esRueda/WeatherStation/CSE/Display Photos/20200113_080433.jpg

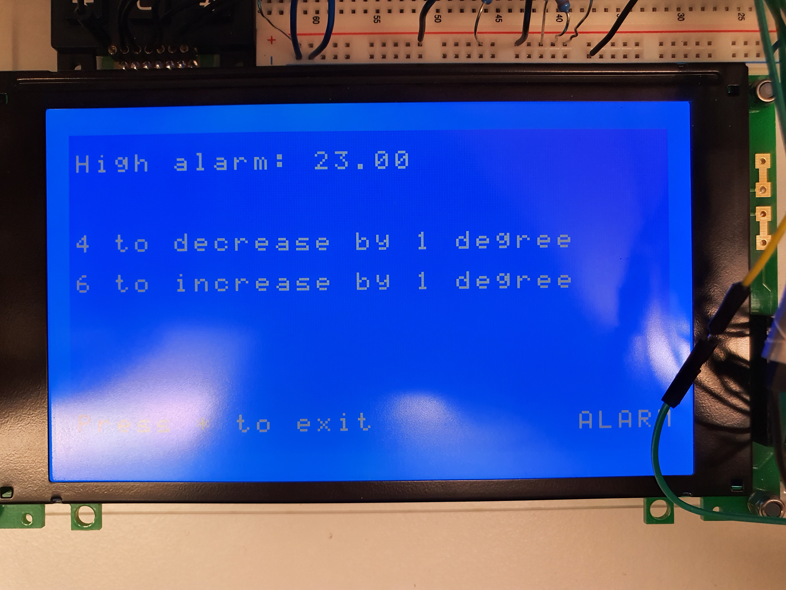
CSE/Display Photos/20200113_080433.jpg
