esRueda/WeatherStation/CSE/Display Photos/20200113_075914.jpg

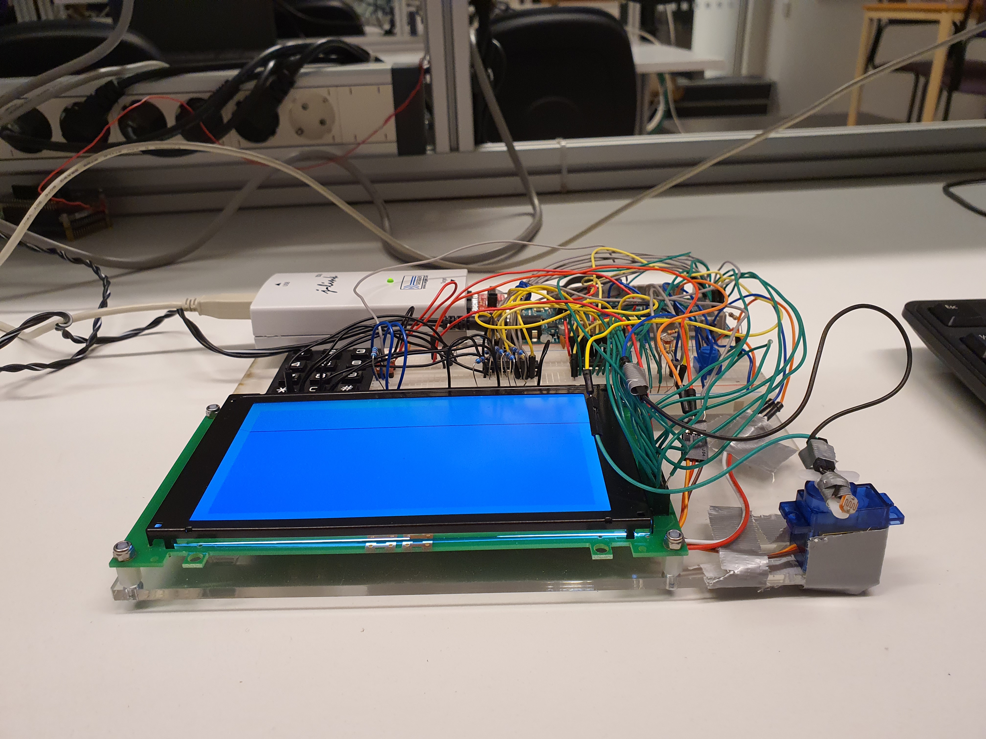
CSE/Display Photos/20200113_075914.jpg
