esRueda/WeatherStation/CSE/Display Photos/20200113_075956.jpg

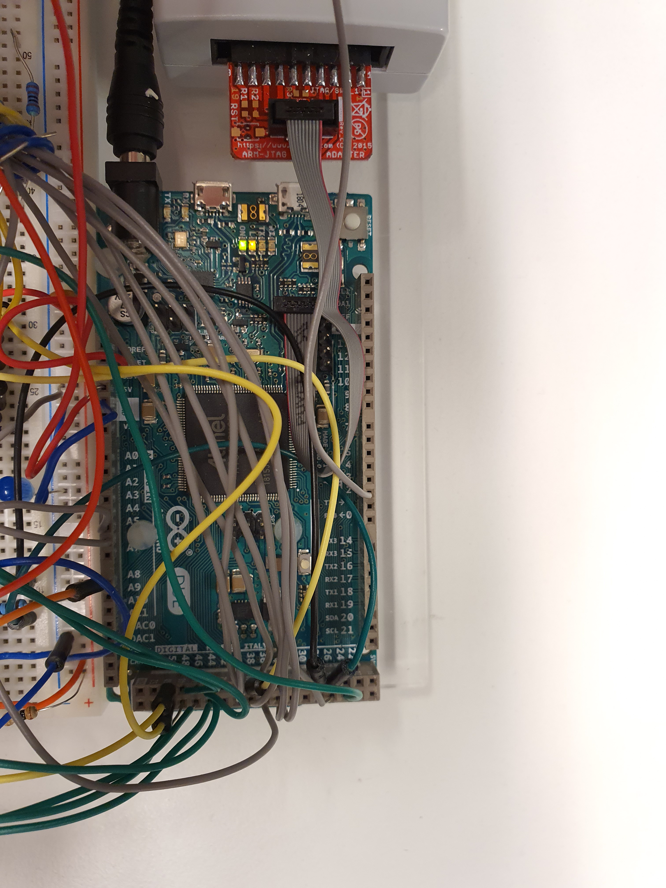
CSE/Display Photos/20200113_075956.jpg
