esRueda/WeatherStation/CSE/Display Photos/20200112_170723.jpg

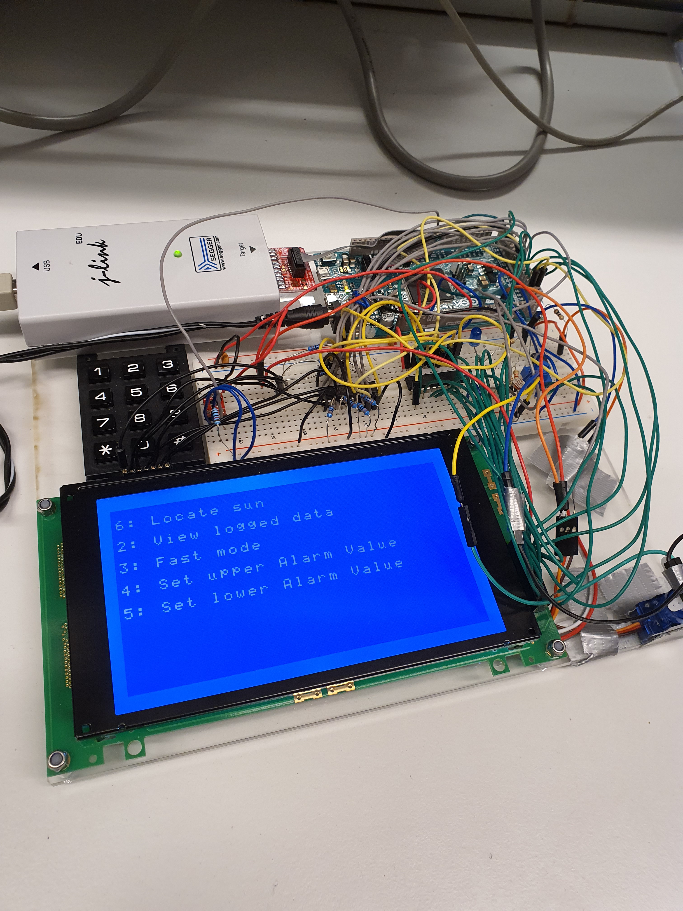
CSE/Display Photos/20200112_170723.jpg
