esRueda/WeatherStation/CSE/Display Photos/20200113_075909.jpg

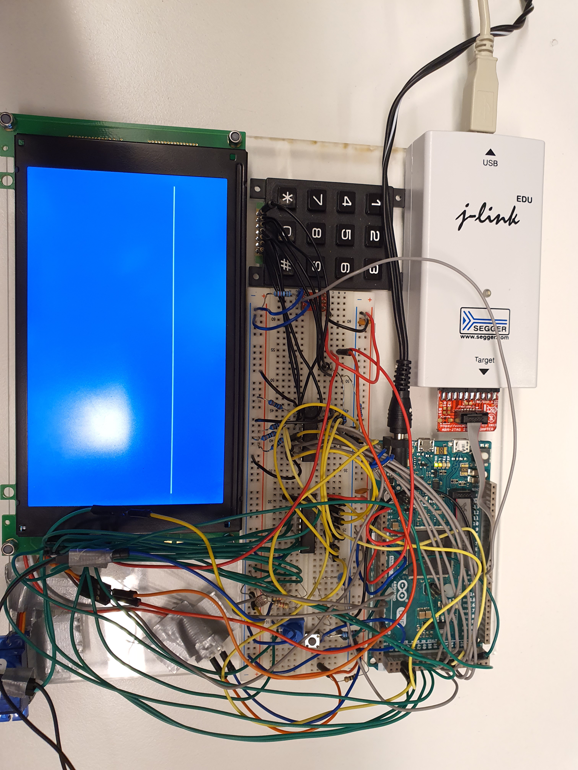
CSE/Display Photos/20200113_075909.jpg
