esRueda/WeatherStation/CSE/Display Photos/20200113_075941.jpg

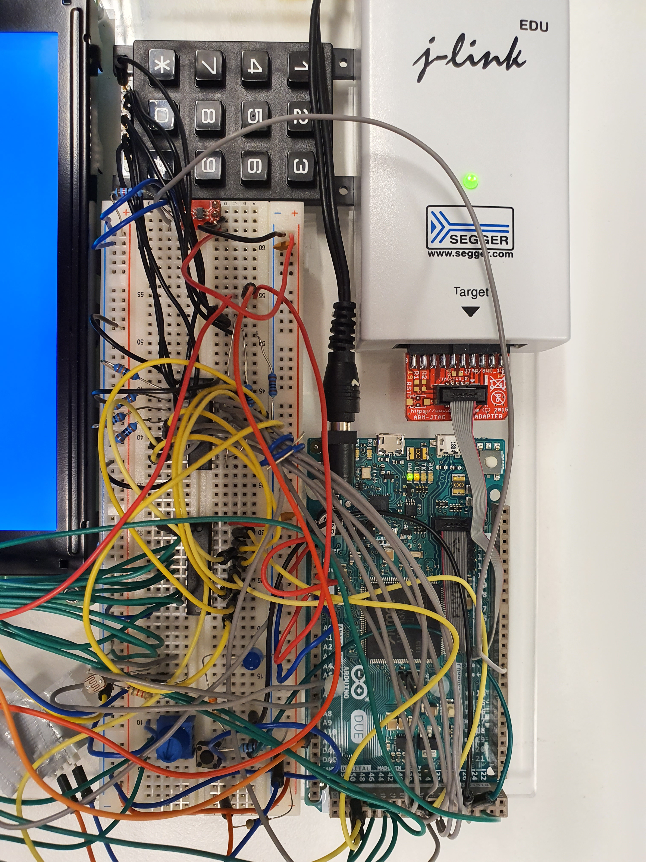
CSE/Display Photos/20200113_075941.jpg
