esRueda/WeatherStation/CSE/Display Photos/20200113_080021.jpg

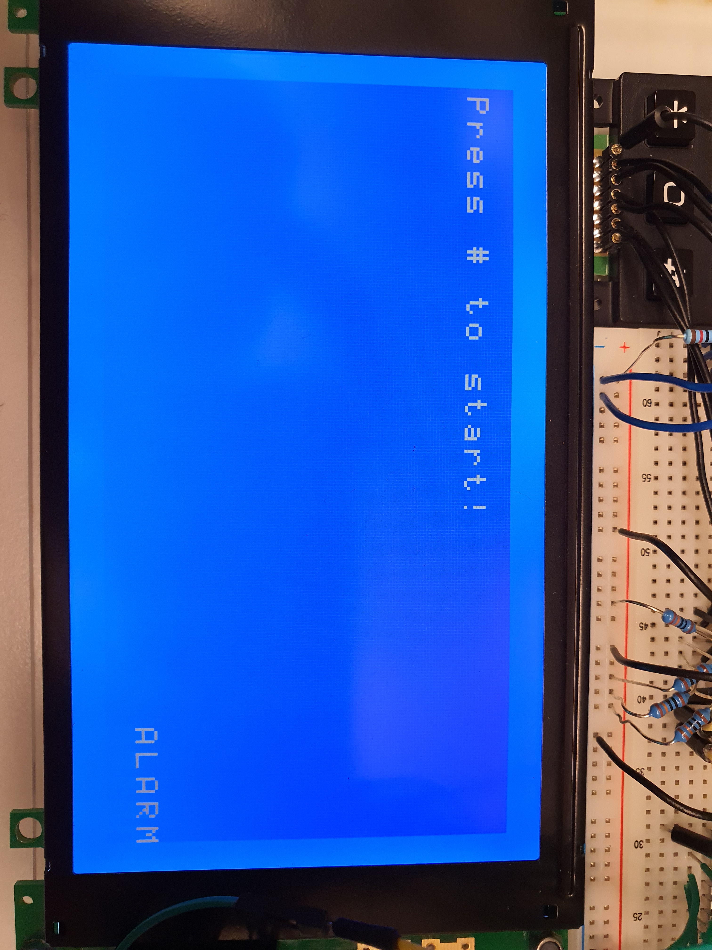
CSE/Display Photos/20200113_080021.jpg
