esRueda/WeatherStation/CSE/Display Photos/20200113_080133.jpg

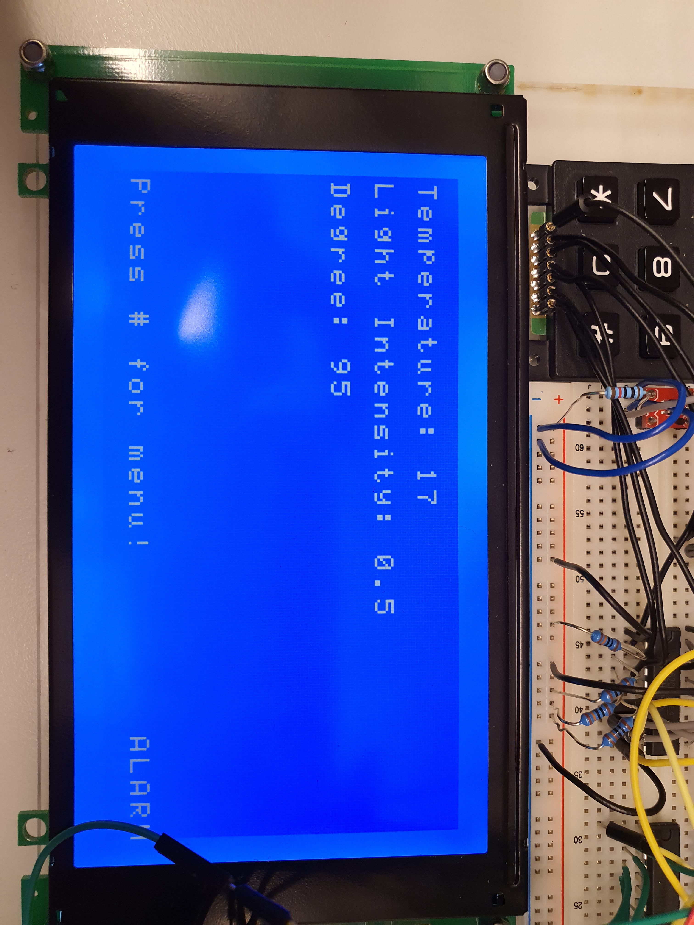
CSE/Display Photos/20200113_080133.jpg
