esRueda/WeatherStation/CSE/Display Photos/20200113_080502.jpg

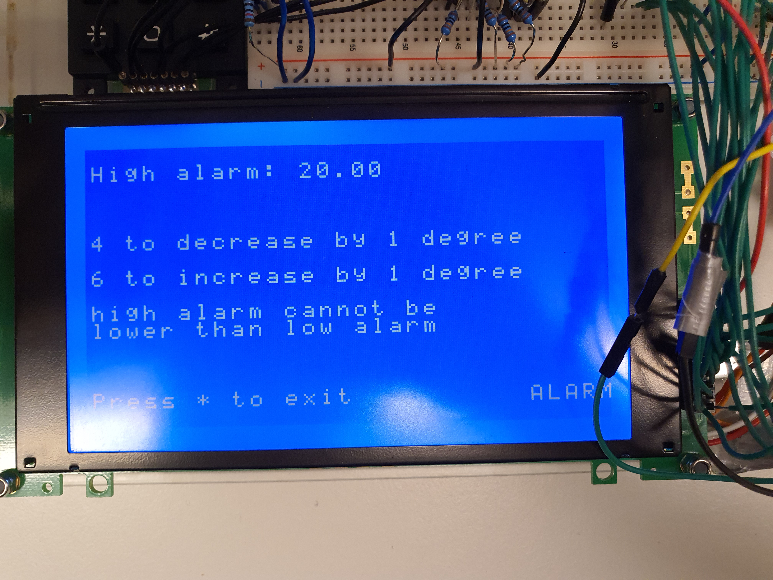
CSE/Display Photos/20200113_080502.jpg
