esRueda/WeatherStation/CSE/Display Photos/20200113_080607.jpg

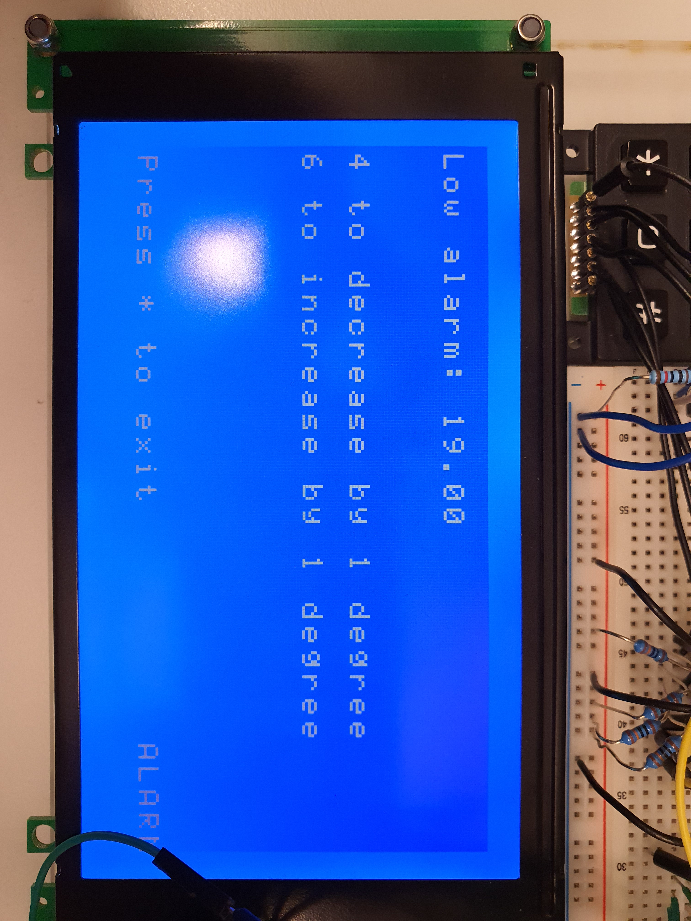
CSE/Display Photos/20200113_080607.jpg
