esRueda/WeatherStation/CSE/Display Photos/20200113_080620.jpg

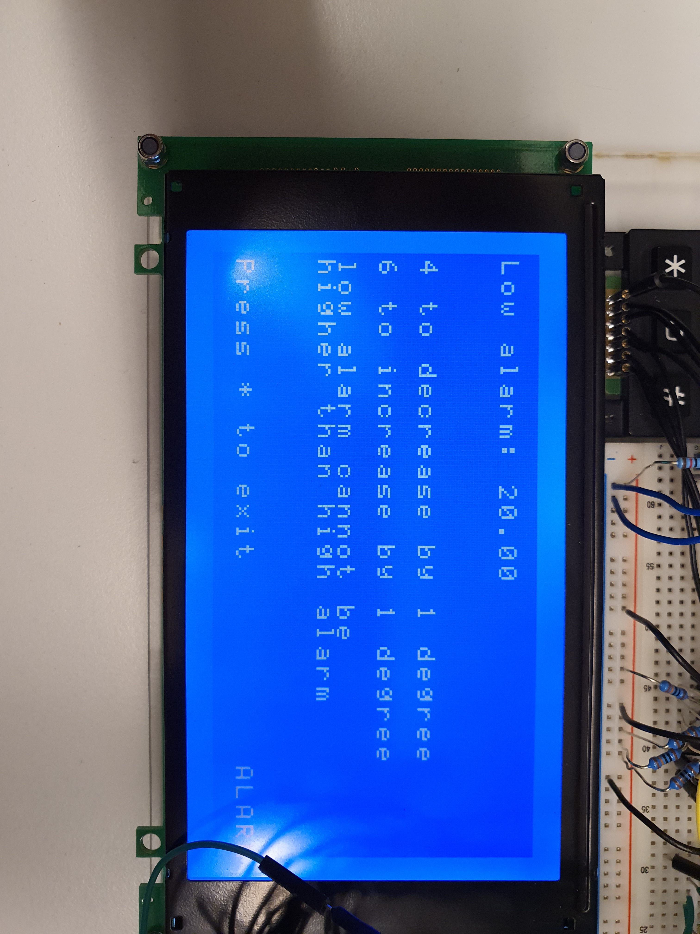
CSE/Display Photos/20200113_080620.jpg
