esRueda/WeatherStation/CSE/Display Photos/20200113_080729.jpg

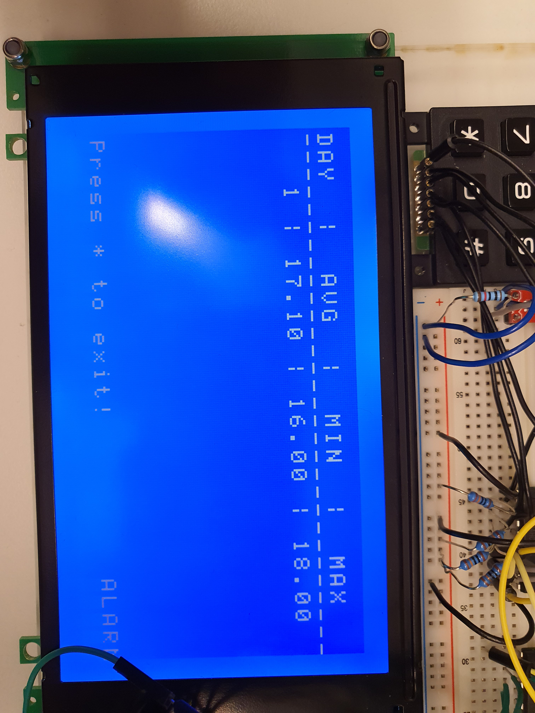
CSE/Display Photos/20200113_080729.jpg
