esRueda/WeatherStation/CSE/Display Photos/20200113_080043.jpg

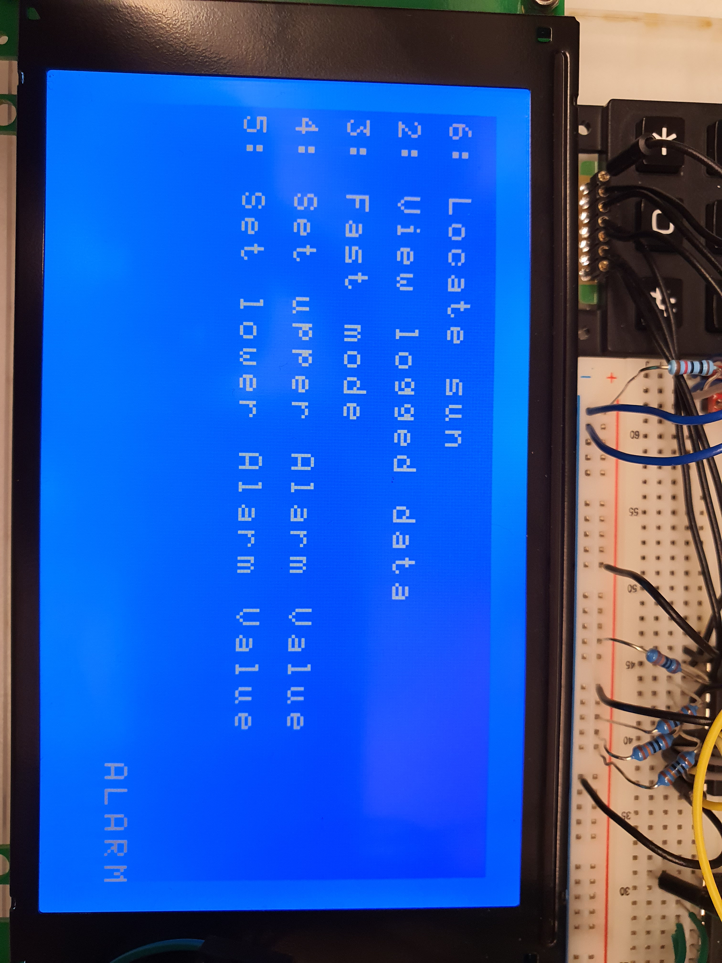
CSE/Display Photos/20200113_080043.jpg
